Stefanhg/CarControllerV3/Documentation/diagrams/simplified_overview.png

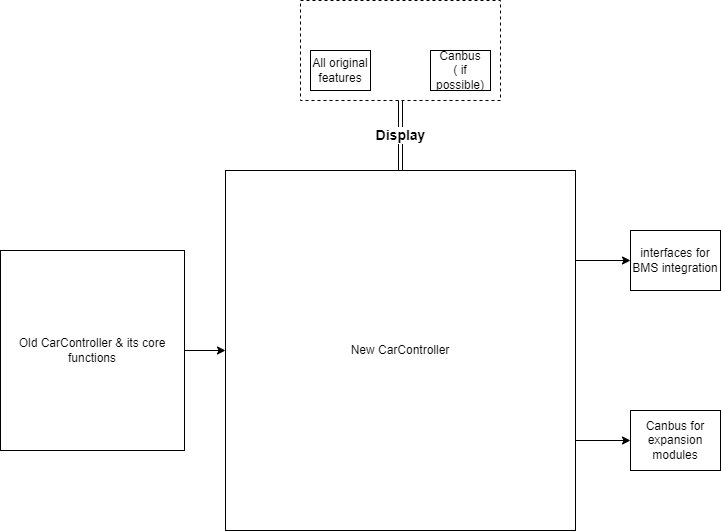
Documentation/diagrams/simplified_overview.png
