Stefanhg/CarControllerV3/Documentation/Todo.md

Schematic
- +LV JP1.4 poly fuse + ferrit bead + 100nF capacitor
- What is "shunt driver S+"
- Remove all the capacitor filters
