Stefanhg/CarControllerV3/PCB/CarControllerV3/CarControllerV3.kicad_pcb

## KiCad design PCB/CarControllerV3/CarControllerV3.kicad_pcb (2026-08-09)

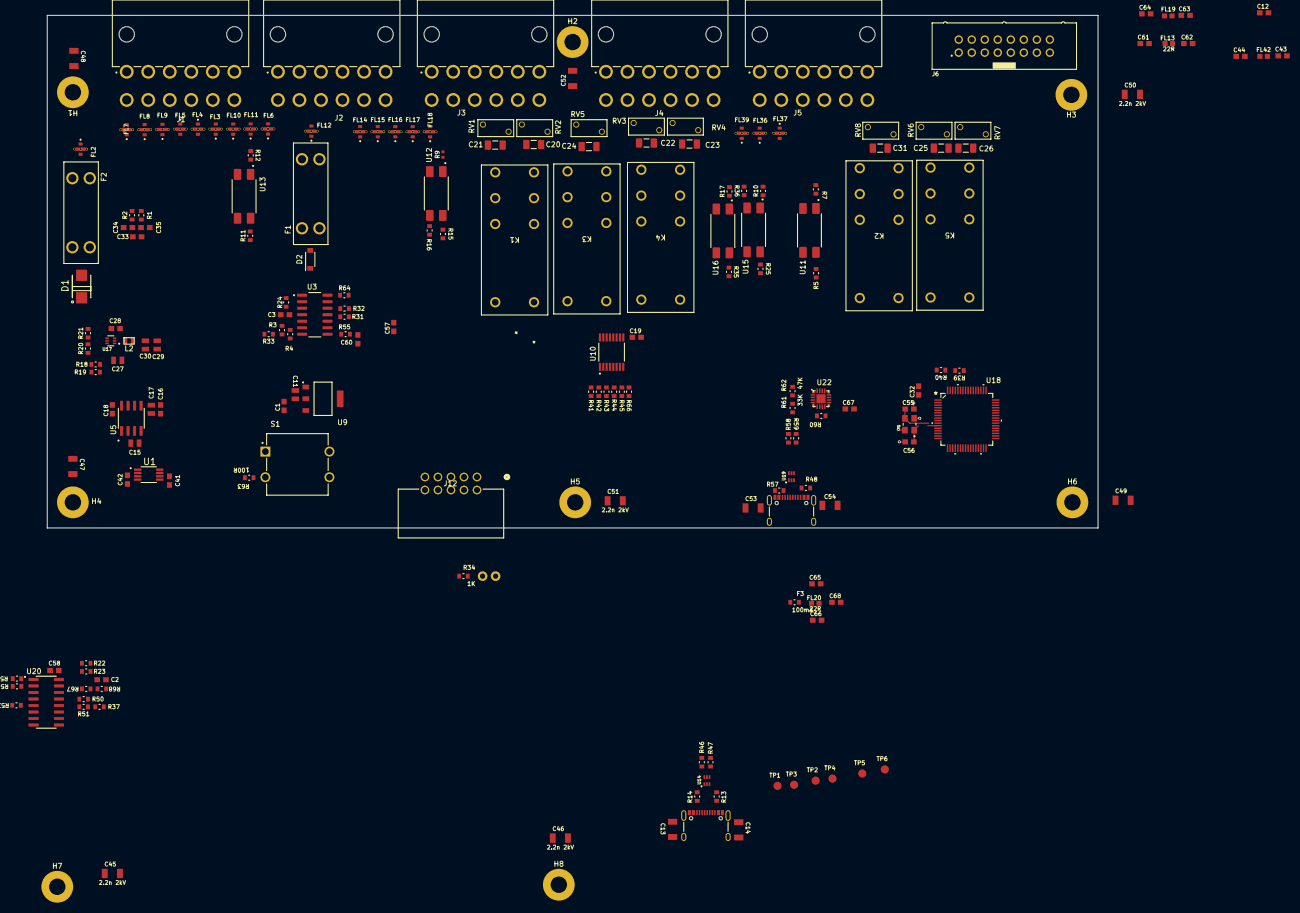
[picture p11: board CarControllerV3.kicad_pcb from above]

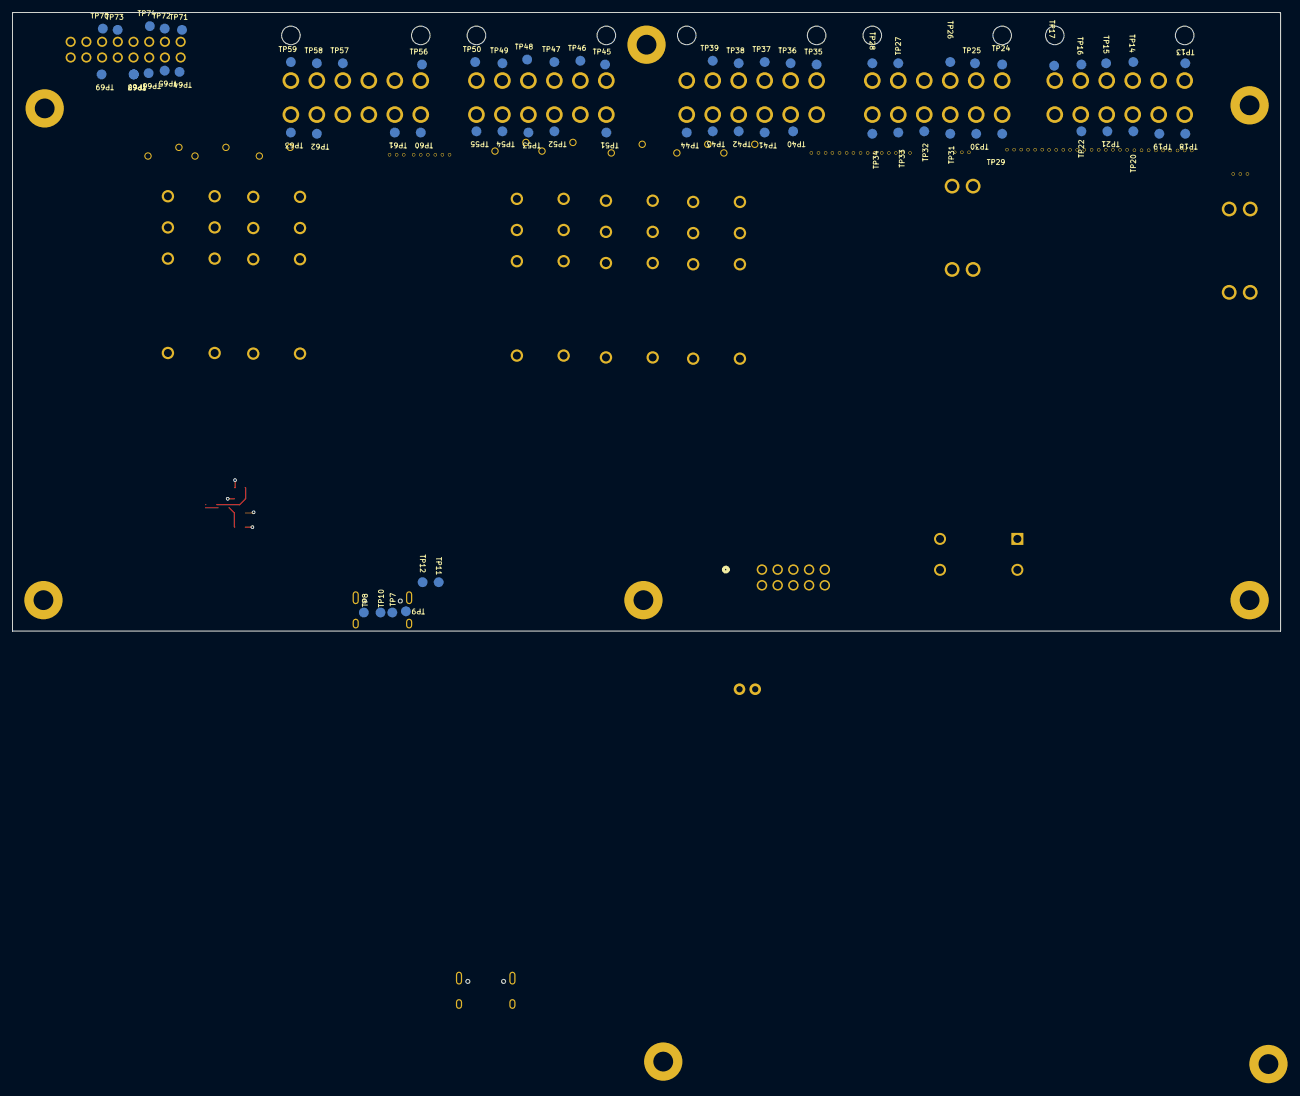
[picture p12: board CarControllerV3.kicad_pcb from below]

Board: 2 copper layers, 205.0 x 100.0 mm, 263 parts (67 on the bottom side), 171 nets.

Parts:
C1, C2, C3, C12, C16, C18, C19, C28, C32, C41, C42, C57, C58, C65, C66, C67: 100n; CAPC1608X90
C11, C15, C17, C27, C29, C30: 10uF; CC0805KKX5R8BB106-CAPC2013X145N
C13, C14, C45, C46, C47, C48, C49, C50, C51, C52, C53, C54: 2.2n 2kV; C1206X222KGRACTU-CAP3216X125N
C20, C21, C22, C23, C24, C25, C26, C31: 100n; CAPC3216X180N
C33, C34, C35, C60: 100p; CAPC1608X90
C43, C44, C61, C62, C63, C64: 10n; CAPC1608X90
C55, C56: 12p; CAPC1608X90
C68: 1uF; CAPC1608X90
D1: SS54B; SS54B-DIOM4336X244N
D2: 1N4007W-T; SODFL3818X130N
F1, F2: 3557-2; FUSE_3557-2
F3: 100mA; FEMTOSMDC010F-2-RESC1608X60N
FL2, FL3, FL4, FL5, FL6, FL7, FL8, FL9, FL10, FL11, FL12, FL14, FL15, FL16, FL17, FL18, FL36, FL37, FL39: 22nF; FIL_NFM21CC223R1H3D
FL13, FL19, FL20, FL42: 22R; BLM18BA220SN1D-BEADC1608X95N
H1, H2, H3, H4, H5, H6, H7, H8: 3.2mm; 3.2mm_plated
J1, J2, J3, J4, J5: 649012227222
J6: 61201621621
J9, J11: USB_C_Receptacle; USB-C_16
J10: Conn_01x02; 1x02
J12: 702471052; CONN_7024710XX_MOL
K1, K2, K3, K4, K5: RT424005; RELAY-SPDT_5mm
L2: 4.7uH; CC0805
R1, R2, R3, R4, R5, R11, R23, R25, R31, R32, R33, R35, R60, R67: 10K; RC0603FR-RESC1608X60N
R7, R12: 22K; RC0603FR-RESC1608X60N.pretty
R9: 1K; RC0402FR-RESC1005X40N
R10, R17: 2.7K; RC0603FR-RESC1608X60N.pretty
R13, R14, R48, R57: 5.1K; RC0603FR-RESC1608X60N.pretty
R15, R16, R55, R63, R64: 100R; RC0603FR-RESC1608X60N.pretty
R18, R21: 7.5K; RC0603FR-RESC1608X60N.pretty
R19, R20: 39K; RC0603FR-RESC1608X60N.pretty
R22: 390K; RC0603FR-RESC1608X60N.pretty
R24, R34, R37, R39, R40, R41, R42, R43, R44, R45, R50, R51, R52, R53, R54, R66, R68: 1K; RC0603FR-RESC1608X60N.pretty
R36: N.M.; RC0603FR-RESC1608X60N.pretty
R46, R47, R58, R59: 22R; RC0603FR-RESC1608X60N.pretty
R61: 33K; RC0603FR-RESC1608X60N.pretty
R62: 47K; RC0603FR-RESC1608X60N.pretty
RV1, RV2, RV3, RV4, RV5, RV6, RV7, RV8: 100V 400A; VAR_B72205S0600K101
S1: TS13-1212-73-BK-260-D; SW_TS13-1212-73-BK-260-D
TP1, TP2, TP3, TP4, TP5, TP6, TP7, TP8, TP9, TP10, TP11, TP12, TP13, TP14, TP15, TP16, TP17, TP18, TP19, TP20, TP21, TP22, TP24, TP25, TP26, TP27, TP28, TP29, TP30, TP31, TP32, TP33, TP34, TP35, TP36, TP37, TP38, TP39, TP40, TP41, TP42, TP43, TP44, TP45, TP46, TP47, TP48, TP49, TP50, TP51, TP52, TP53, TP54, TP55, TP56, TP57, TP58, TP59, TP60, TP61, TP62, TP63, TP64, TP65, TP66, TP67, TP68, TP69, TP70, TP71, TP72, TP73, TP74: TP_B1_6; testpoints-B1_6
U1: REF5025AIDGKT; REF5025AIDGKT-SOP65P490X110-8N
U3: OPA4188AIDR; SOIC127P600X175-14N
U5: ICL7660AIBAZA; SOIC127P600X175-8N
U9: AMS1117-3.3; SOT229P700X180-4N
U10: ULN2003APW; SOP65P640X120-16N
U11, U12, U13, U15, U16: PC817X1NIP1B; SOIC254P960X420-4N
U14, U19: USBLC6-2P6; USBLC6-2P6-SOT50P160X60-6N
U17: AP62200Z6-7; SOT50P160X60-6N
U18: STM32C092RCT6; LQFP64_STM
U20: CD4051BM96; SOIC127P600X175-16N
U22: CP2102N-A01-GQFN20R; SILABS_QFN20
Y1: 16MHz; XTAL_ECS-160-12-33Q-JES-TR

Connections:
+3V3: C3.2 (C2), C11.2, C32.1 (C1), C58.1 (C1), R5.1 (R1), R11.1 (R1), R25.2 (R2), R34.1 (R1), R35.2 (R2), R37.1 (R1), R39.1 (R1), R40.1 (R1), U3.4 (V+), U9.2 (VOUT), U14.5 (VBUS), U18.8 (VDD/VDDA), U19.5 (VBUS), U20.16 (VDD)
+5V: C1.1 (C1), C19.1 (C1), C29.2, C30.2, C42.2 (C2), C62.2 (C2), FL13.1 (R1), FL36.1, K1.A1 (+), K2.A1 (+), K3.A1 (+), K4.A1 (+), K5.A1 (+), L2.2, R19.1 (R1), U1.2 (VIN), U9.3 (VIN), U10.9 (COM)
+12V: C18.2 (C2), C27.2, C44.2 (C2), D1.C, FL4.3, FL42.1 (R1), R20.1 (R1), U5.8 (V+), U17.1 (VIN)
+12v_sense: C2.1 (C1), R67.2 (R2), R68.1 (R1), U20.14 (CH1_IN/OUT)
+HV: D2.1 (C), R22.1 (R1)
-12V: C16.2 (C2), C17.2, C64.2 (C2), FL19.1 (R1), U5.5 (VOUT)
ACCELERATOR_SWITCH: R11.2 (R2), U13.4, U18.59 (PB5)
ADC_INPUT: C60.2 (C2), R55.1 (R1)
Buzzer: J6.9, U18.27 (PB0)
CHARGER_STOP_SIG: R25.1 (R1), U15.4, U18.61 (PB7)
DCDC_EN: R9.1 (R1), U18.28 (PB1)
Earth: C19.2 (C2), C45.2 (C2), C46.2 (C2), C47.1 (C1), C48.1 (C1), C49.2 (C2), C50.2 (C2), C51.1 (C1), C52.1 (C1), FL2.2, FL2.2_1, FL2.2_2, FL2.2_3, FL2.2_4, FL3.2, FL3.2_1, FL3.2_2, FL3.2_3, FL3.2_4, FL4.2, FL4.2_1, FL4.2_2, FL4.2_3, FL4.2_4, FL5.2, FL5.2_1, FL5.2_2, FL5.2_3, FL5.2_4, FL6.2, FL6.2_1, FL6.2_2, FL6.2_3, FL6.2_4, FL7.2, FL7.2_1, FL7.2_2, FL7.2_3, FL7.2_4, FL8.2, FL8.2_1, FL8.2_2, FL8.2_3, FL8.2_4, FL9.2, FL9.2_1, FL9.2_2, FL9.2_3, FL9.2_4, FL10.2, FL10.2_1, FL10.2_2, FL10.2_3, FL10.2_4, FL11.2, FL11.2_1, FL11.2_2, FL11.2_3, FL11.2_4, FL12.2, FL12.2_1, FL12.2_2, FL12.2_3, FL12.2_4, FL14.2, FL14.2_1, FL14.2_2, FL14.2_3, FL14.2_4, FL15.2, FL15.2_1, FL15.2_2, FL15.2_3, FL15.2_4, FL16.2, FL16.2_1, FL16.2_2, FL16.2_3, FL16.2_4, FL17.2, FL17.2_1, FL17.2_2, FL17.2_3, FL17.2_4, FL18.2, FL18.2_1, FL18.2_2, FL18.2_3, FL18.2_4, FL36.2, FL36.2_1, FL36.2_2, FL36.2_3, FL36.2_4, FL37.2, FL37.2_1, FL37.2_2, FL37.2_3, FL37.2_4, FL39.2, FL39.2_1, FL39.2_2, FL39.2_3, FL39.2_4
GND: C1.2 (C2), C3.1 (C1), C11.1, C12.2 (C2), C13.1 (C1), C14.1 (C1), C16.1 (C1), C17.1, C18.1 (C1), C27.1, C29.1, C30.1, C32.2 (C2), C34.1 (C1), C35.2 (C2), C41.1 (C1), C42.1 (C1), C43.1 (C1), C44.1 (C1), C53.1 (C1), C54.1 (C1), C55.2 (C2), C56.2 (C2), C57.2 (C2), C58.2 (C2), C60.1 (C1), C61.1 (C1), C62.1 (C1), C63.1 (C1), C64.1 (C1), C65.1 (C1), C66.1 (C1), C67.2 (C2), C68.1 (C1), FL3.3, FL6.3, FL10.1, FL18.1, FL37.3, J6.11, J6.13, J6.15, J9.GND, J11.GND, J12.3, J12.8, R13.2 (R2), R14.2 (R2), R18.2 (R2), R21.2 (R2), R23.2 (R2), R24.2 (R2), R32.2 (R2), R36.1 (R1), R48.2 (R2), R57.2 (R2), R62.2 (R2), R63.2 (R2), R66.2 (R2), TP5.TP, TP11.TP, TP69.TP, U1.4 (GND), U3.11 (V-), U5.3 (GND), U9.1 (GND/ADJ), U10.8 (E), U11.2, U11.3, U12.2, U13.2, U13.3, U14.2 (GND), U15.3, U16.3, U17.3 (GND), U18.9 (VSS/VSSA), U19.2 (GND), U20.7 (VEE), U20.8 (VSS), U22.3 (GND), U22.12 (GND), U22.21 (GND), Y1.2, Y1.4
I2C_ADDR_SEL: J6.4, TP72.TP, U18.29 (PB2)
I2C_ADDR_SEL_2: J6.2, TP71.TP
I2C_SCL: J6.3, R39.2 (R2), TP65.TP, U18.62 (PB8)
I2C_SDA: J6.1, R40.2 (R2), TP64.TP, U18.63 (PB9)
IGNITION_ON: R35.1 (R1), U16.4, U18.60 (PB6)
K1_SIG: R41.2 (R2), U18.31 (PB11)
K2_SIG: R42.2 (R2), U18.32 (PB12)
K3_SIG: R43.2 (R2), U18.33 (PB13)
K4_SIG: R44.2 (R2), U18.34 (PB14)
K5_SIG: R45.2 (R2), U18.35 (PB15)
LDR_Senser: J6.7, R54.2 (R2), TP67.TP, TP68.TP
MCU_RST: J12.1, S1.1, S1.2, U18.12 (PF2-NRST)
NTC: FL9.1, R37.2 (R2), R51.2 (R2)
unnamed: C2.2 (C2), J4.12, R68.2 (R2), TP55.TP
unnamed: C12.1 (C1), C61.2 (C2), FL13.2 (R2), J6.12, J6.14, J6.16, TP70.TP
unnamed: C13.2 (C2), C14.2 (C2), J9.S (SHIELD)
unnamed: C28.1 (C1), L2.1, U17.2 (SW)
unnamed: C28.2 (C2), U17.4 (BST)
unnamed: C33.1 (C1), C34.2 (C2), R2.1 (R1), R4.1 (R1), U3.6 (-IN)
unnamed: C33.2 (C2), C35.1 (C1), R1.1 (R1), R3.2 (R2), U3.5 (+IN)
unnamed: C43.2 (C2), FL42.2 (R2), J6.6, TP74.TP
unnamed: C45.1 (C1), H7.1
unnamed: C46.1 (C1), H8.1
unnamed: C47.2 (C2), H4.1
unnamed: C48.2 (C2), H1.1
unnamed: C49.1 (C1), H6.1
unnamed: C50.1 (C1), H3.1
unnamed: C51.2 (C2), H5.1
unnamed: C52.2 (C2), H2.1
unnamed: C53.2 (C2), C54.2 (C2), J11.S (SHIELD)
unnamed: C55.1 (C1), U18.10 (PF0-OSC_IN), Y1.3
unnamed: C56.1 (C1), U18.11 (PF1-OSC_OUT), Y1.1
unnamed: C63.2 (C2), FL19.2 (R2), J6.10, TP73.TP
unnamed: C65.2 (C2), C68.2 (C2), FL20.1 (R1), R61.1 (R1), U22.7 (VREGIN)
unnamed: C66.2 (C2), F3.2, FL20.2 (R2)
unnamed: C67.1 (C1), R60.2 (R2), U22.6 (VDD)
unnamed: D1.A, F2.2_1, F2.2_2
unnamed: D2.2 (A), F1.1_1, F1.1_2
unnamed: F1.2_1, F1.2_2, FL12.1
unnamed: F2.1_1, F2.1_2, FL2.3
unnamed: FL2.1, J1.1, TP13.TP
unnamed: FL3.1, J1.3, TP14.TP
unnamed: FL4.1, J1.4, TP15.TP
unnamed: FL5.1, J1.5, TP16.TP
unnamed: FL6.1, J1.6, TP17.TP
unnamed: FL7.3, J1.7, TP18.TP
unnamed: FL8.3, J1.8, TP19.TP
unnamed: FL9.3, J1.9, TP20.TP
unnamed: FL10.3, J1.10, TP21.TP
unnamed: FL11.3, J1.11, TP22.TP
unnamed: FL12.3, J2.12, TP34.TP
unnamed: FL14.3, J3.1, TP35.TP
unnamed: FL15.3, J3.2, TP36.TP
unnamed: FL16.3, J3.3, TP37.TP
unnamed: FL17.3, J3.4, TP38.TP
unnamed: FL18.3, J3.5, J3.7, TP39.TP
unnamed: FL36.3, J5.7, TP60.TP
unnamed: FL37.1, J5.8, TP61.TP
unnamed: FL39.3, J5.1, TP56.TP
unnamed: J2.1, TP24.TP
unnamed: J2.2, TP25.TP
unnamed: J2.3, TP26.TP
unnamed: J2.5, TP27.TP
unnamed: J2.6, TP28.TP
unnamed: J2.7, TP29.TP
unnamed: J2.8, TP30.TP
unnamed: J2.9, TP31.TP
unnamed: J2.10, TP32.TP
unnamed: J2.11, TP33.TP
unnamed: J9.A5 (CC1), R14.1 (R1), TP1.TP
unnamed: J9.B5 (CC2), R13.1 (R1), TP2.TP
unnamed: J10.1, R34.2 (R2)
unnamed: J11.A5 (CC1), R57.1 (R1), TP7.TP
unnamed: J11.B5 (CC2), R48.1 (R1), TP8.TP
unnamed: C20.2, C21.2, J3.10, K1.11 (COM), K1.21 (COM), RV1.2, RV2.2, TP42.TP
unnamed: C20.1, J3.12, K1.12 (NC), K1.22 (NC), RV2.1, TP44.TP
unnamed: C21.1, J3.11, K1.14 (NO), K1.24 (NO), RV1.1, TP43.TP
unnamed: K1.A2 (-), U10.16 (1C)
unnamed: C31.2, J5.11, K2.11 (COM), K2.21 (COM), RV8.2, TP62.TP
unnamed: C31.1, J5.12, K2.12 (NC), K2.22 (NC), RV8.1, TP63.TP
unnamed: K2.14 (NO), K2.24 (NO)
unnamed: K2.A2 (-), U10.15 (2C)
unnamed: C24.1, J4.2, K3.11 (COM), K3.21 (COM), RV5.1, TP46.TP
unnamed: C24.2, J4.1, K3.12 (NC), K3.22 (NC), RV5.2, TP45.TP
unnamed: K3.A2 (-), U10.14 (3C)
unnamed: C22.2, C23.2, J4.3, K4.11 (COM), K4.21 (COM), RV3.2, RV4.2, TP47.TP
unnamed: C23.1, J4.5, K4.12 (NC), K4.22 (NC), RV4.1, TP49.TP
unnamed: C22.1, J4.4, K4.14 (NO), K4.24 (NO), RV3.1, TP48.TP
unnamed: K4.A2 (-), U10.13 (4C)
unnamed: C25.2, C26.2, J5.4, K5.11 (COM), K5.21 (COM), RV6.2, RV7.2, TP57.TP
unnamed: C26.1, J5.6, K5.12 (NC), K5.22 (NC), RV7.1, TP59.TP
unnamed: C25.1, J5.5, K5.14 (NO), K5.24 (NO), RV6.1, TP58.TP
unnamed: K5.A2 (-), U10.12 (5C)
unnamed: R3.1 (R1), R33.2 (R2), U3.7 (OUT)
unnamed: J4.6, R7.1 (R1), TP50.TP
unnamed: R7.2 (R2), U11.1
unnamed: R9.2 (R2), U12.1
unnamed: R10.1 (R1), U15.1
unnamed: J4.7, R10.2 (R2), TP51.TP
unnamed: FL11.1, R12.1 (R1)
unnamed: R12.2 (R2), U13.1
unnamed: R15.1 (R1), U12.4
unnamed: J3.8, R15.2 (R2), TP40.TP
unnamed: R16.1 (R1), U12.3
unnamed: J3.9, R16.2 (R2), TP41.TP
unnamed: R17.1 (R1), U16.1
unnamed: J4.9, R17.2 (R2), TP52.TP
unnamed: R18.1 (R1), R19.2 (R2), U17.6 (FB)
unnamed: R20.2 (R2), R21.1 (R1), U17.5 (EN)
unnamed: R22.2 (R2), R23.1 (R1), U20.15 (CH2_IN/OUT)
unnamed: R24.1 (R1), U3.3 (+IN)
unnamed: R31.2 (R2), R32.1 (R1), U3.12 (+IN)
unnamed: J4.10, R36.2 (R2), TP53.TP, U15.2, U16.2
unnamed: R41.1 (R1), U10.1 (1B)
unnamed: R42.1 (R1), U10.2 (2B)
unnamed: R43.1 (R1), U10.3 (3B)
unnamed: R44.1 (R1), U10.4 (4B)
unnamed: R45.1 (R1), U10.5 (5B)
unnamed: R46.2 (R2), U14.6 (I/O1_2)
unnamed: R47.2 (R2), U14.4 (I/O2_2)
unnamed: R50.1 (R1), U20.13 (CH0_IN/OUT)
unnamed: R51.1 (R1), U20.12 (CH3_IN/OUT)
unnamed: R52.1 (R1), U20.1 (CH4_IN/OUT)
unnamed: R53.1 (R1), U20.5 (CH5_IN/OUT)
unnamed: R54.1 (R1), U20.2 (CH6_IN/OUT)
unnamed: R55.2 (R2), U3.8 (OUT), U3.9 (-IN)
unnamed: R58.2 (R2), U19.6 (I/O1_2)
unnamed: R59.2 (R2), U19.4 (I/O2_2)
unnamed: R60.1 (R1), U22.9 (RST)
unnamed: R61.2 (R2), R62.1 (R1), U22.8 (VBUS)
unnamed: R63.1 (R1), S1.3, S1.4
unnamed: R64.2 (R2), U3.13 (-IN), U3.14 (OUT)
unnamed: R66.1 (R1), U10.6 (6B), U10.7 (7B)
unnamed: J4.11, R67.1 (R1), TP54.TP
unnamed: U1.1 (DNC), U1.8 (DNC)
unnamed: U3.1 (OUT), U3.2 (-IN)
unnamed: C15.1, U5.2 (CAP+)
unnamed: C15.2, U5.4 (CAP-)
unnamed: J9.A6 (D+), J9.B6 (D+), TP3.TP, U14.1 (I/O1_1)
unnamed: J9.A7 (D-), J9.B7 (D-), TP4.TP, U14.3 (I/O2_1)
unnamed: J11.A6 (D+), J11.B6 (D+), TP9.TP, U19.1 (I/O1_1)
unnamed: J11.A7 (D-), J11.B7 (D-), TP10.TP, U19.3 (I/O2_1)
unnamed: U3.10 (+IN), U20.3 (COM_OUT/IN)
REV_SIG: R5.2 (R2), U11.4, U18.58 (PB4)
SHUNT_ANA: R33.1 (R1), R52.2 (R2)
SPEEDMODE_ANA: FL39.1, R53.2 (R2)
SWDCLK_BOOT0: J10.2, J12.6, U18.46 (PA14-BOOT0)
SWDIO: J12.7, U18.45 (PA13)
Shunt+: FL7.1, FL14.1, R2.2 (R2)
Shunt-: FL8.1, FL15.1, R1.2 (R2)
UART_RX: U18.25 (PC4), U22.17 (RXD)
UART_TX: U18.26 (PC5), U22.18 (TXD)
USB_d+: R46.1 (R1), R58.1 (R1), U22.4 (D+)
USB_d-: R47.1 (R1), R59.1 (R1), U22.5 (D-)
VBUS: F3.1, J9.VBUS, J11.VBUS, TP6.TP, TP12.TP
VREF: C41.2 (C2), C57.1 (C1), R31.1 (R1), U1.6 (VOUT), U18.7 (VREF+)
VREF/2: R4.2 (R2), R50.2 (R2), R64.1 (R1)
trip_button: J6.5, TP66.TP, U18.57 (PB3)
