Stefanhg/CarControllerV3/(commit log)

2026-08-09 Initial work of the CC
    Saved initial work of CC
    [CarControllerV3.kicad_pcb, CarControllerV3.kicad_sch, analog.kicad_sch, bms.kicad_sch, connectors.kicad_sch, connectors2.kicad_sch, connectors3.kicad_sch, connectors_other.kicad_sch]
2026-08-12 More work to PCB
    - Rerouted bunch of connections
    - Added alternative charge pump circuit
    - Bunch of work on analog circuit
    - Removed all the capacitor filter on the connectors in favor of filtering when nessesary.
    - Placed canbus on JP5.2, JP5.3
    - Disconnected various connections that needs to be decided if we should use.
    - Added protection to various areas
    - Added various todo notes everywhere..
    [analog.kicad_sch, connectors.kicad_sch, connectors2.kicad_sch, connectors3.kicad_sch, connectors_other.kicad_sch, mcu.kicad_sch, power.kicad_sch]
